sharkie-0000/split-keyboard/bom.csv

Name | Quantity | Price | Total cost | Currency | URL
Seeed Studio XIAO RP2040 v1.0 | 2 | 5.64 | 11.28 | USD | https://robu.in/product/seeed-studio-xiao-rp2040-v1-0/
Blank Pudding Keycap Set | 1 | 15.99 | 15.99 | USD | https://meckeys.com/shop/accessories/keyboard-accessories/keycaps/blank-pudding-keycap-set/
DIODE-1N4148-SOD-80 (SKU 1415737) | 52 | 0.0109 | 0.57 | USD | https://robu.in/product/diode-1n4148/
PCB fabrication (JLCPCB order) | 1 | 23.00 | 23.00 | USD | https://jlcpcb.com/
LHGJFKO 3-pin mechanical keyboard switches (150-piece pack) | 1 | 18.11 | 18.11 | USD | https://www.amazon.in/dp/B0GFDG9GB7
TOTAL |  |  | 68.95 | USD
