sharkie-0000/split-keyboard/3d/s-split-keyboard.step

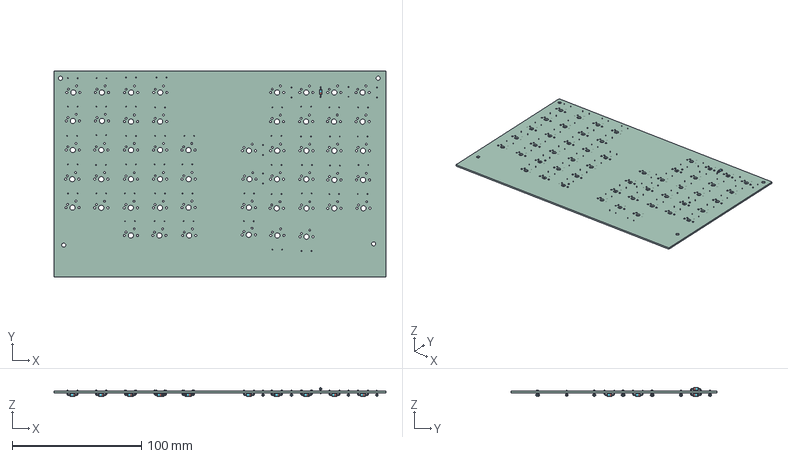
[picture p6: CAD file, 2026-11-12]
3d/s-split-keyboard.step
256.5 x 159.1 x 6.70 mm
D_DO-35_SOD27_P7.62mm_Horizontal x 52
s-split-keyboard-unsaved-export-dYNJtc_PCB
