sharkie-0000/split-keyboard/3d/printable-s-split-keyboard.stl

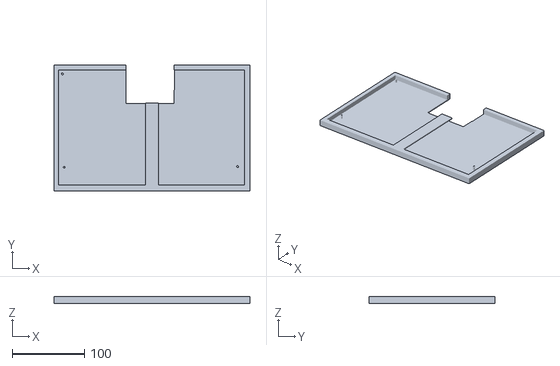
[picture p7: CAD file, 2026-11-12]
3d/printable-s-split-keyboard.stl
270.7 x 173.8 x 9.00
