sharkie-0000/split-keyboard/kicad/s-split-keyboard.kicad_pcb

## KiCad design kicad/s-split-keyboard.kicad_pcb (2026-11-12)

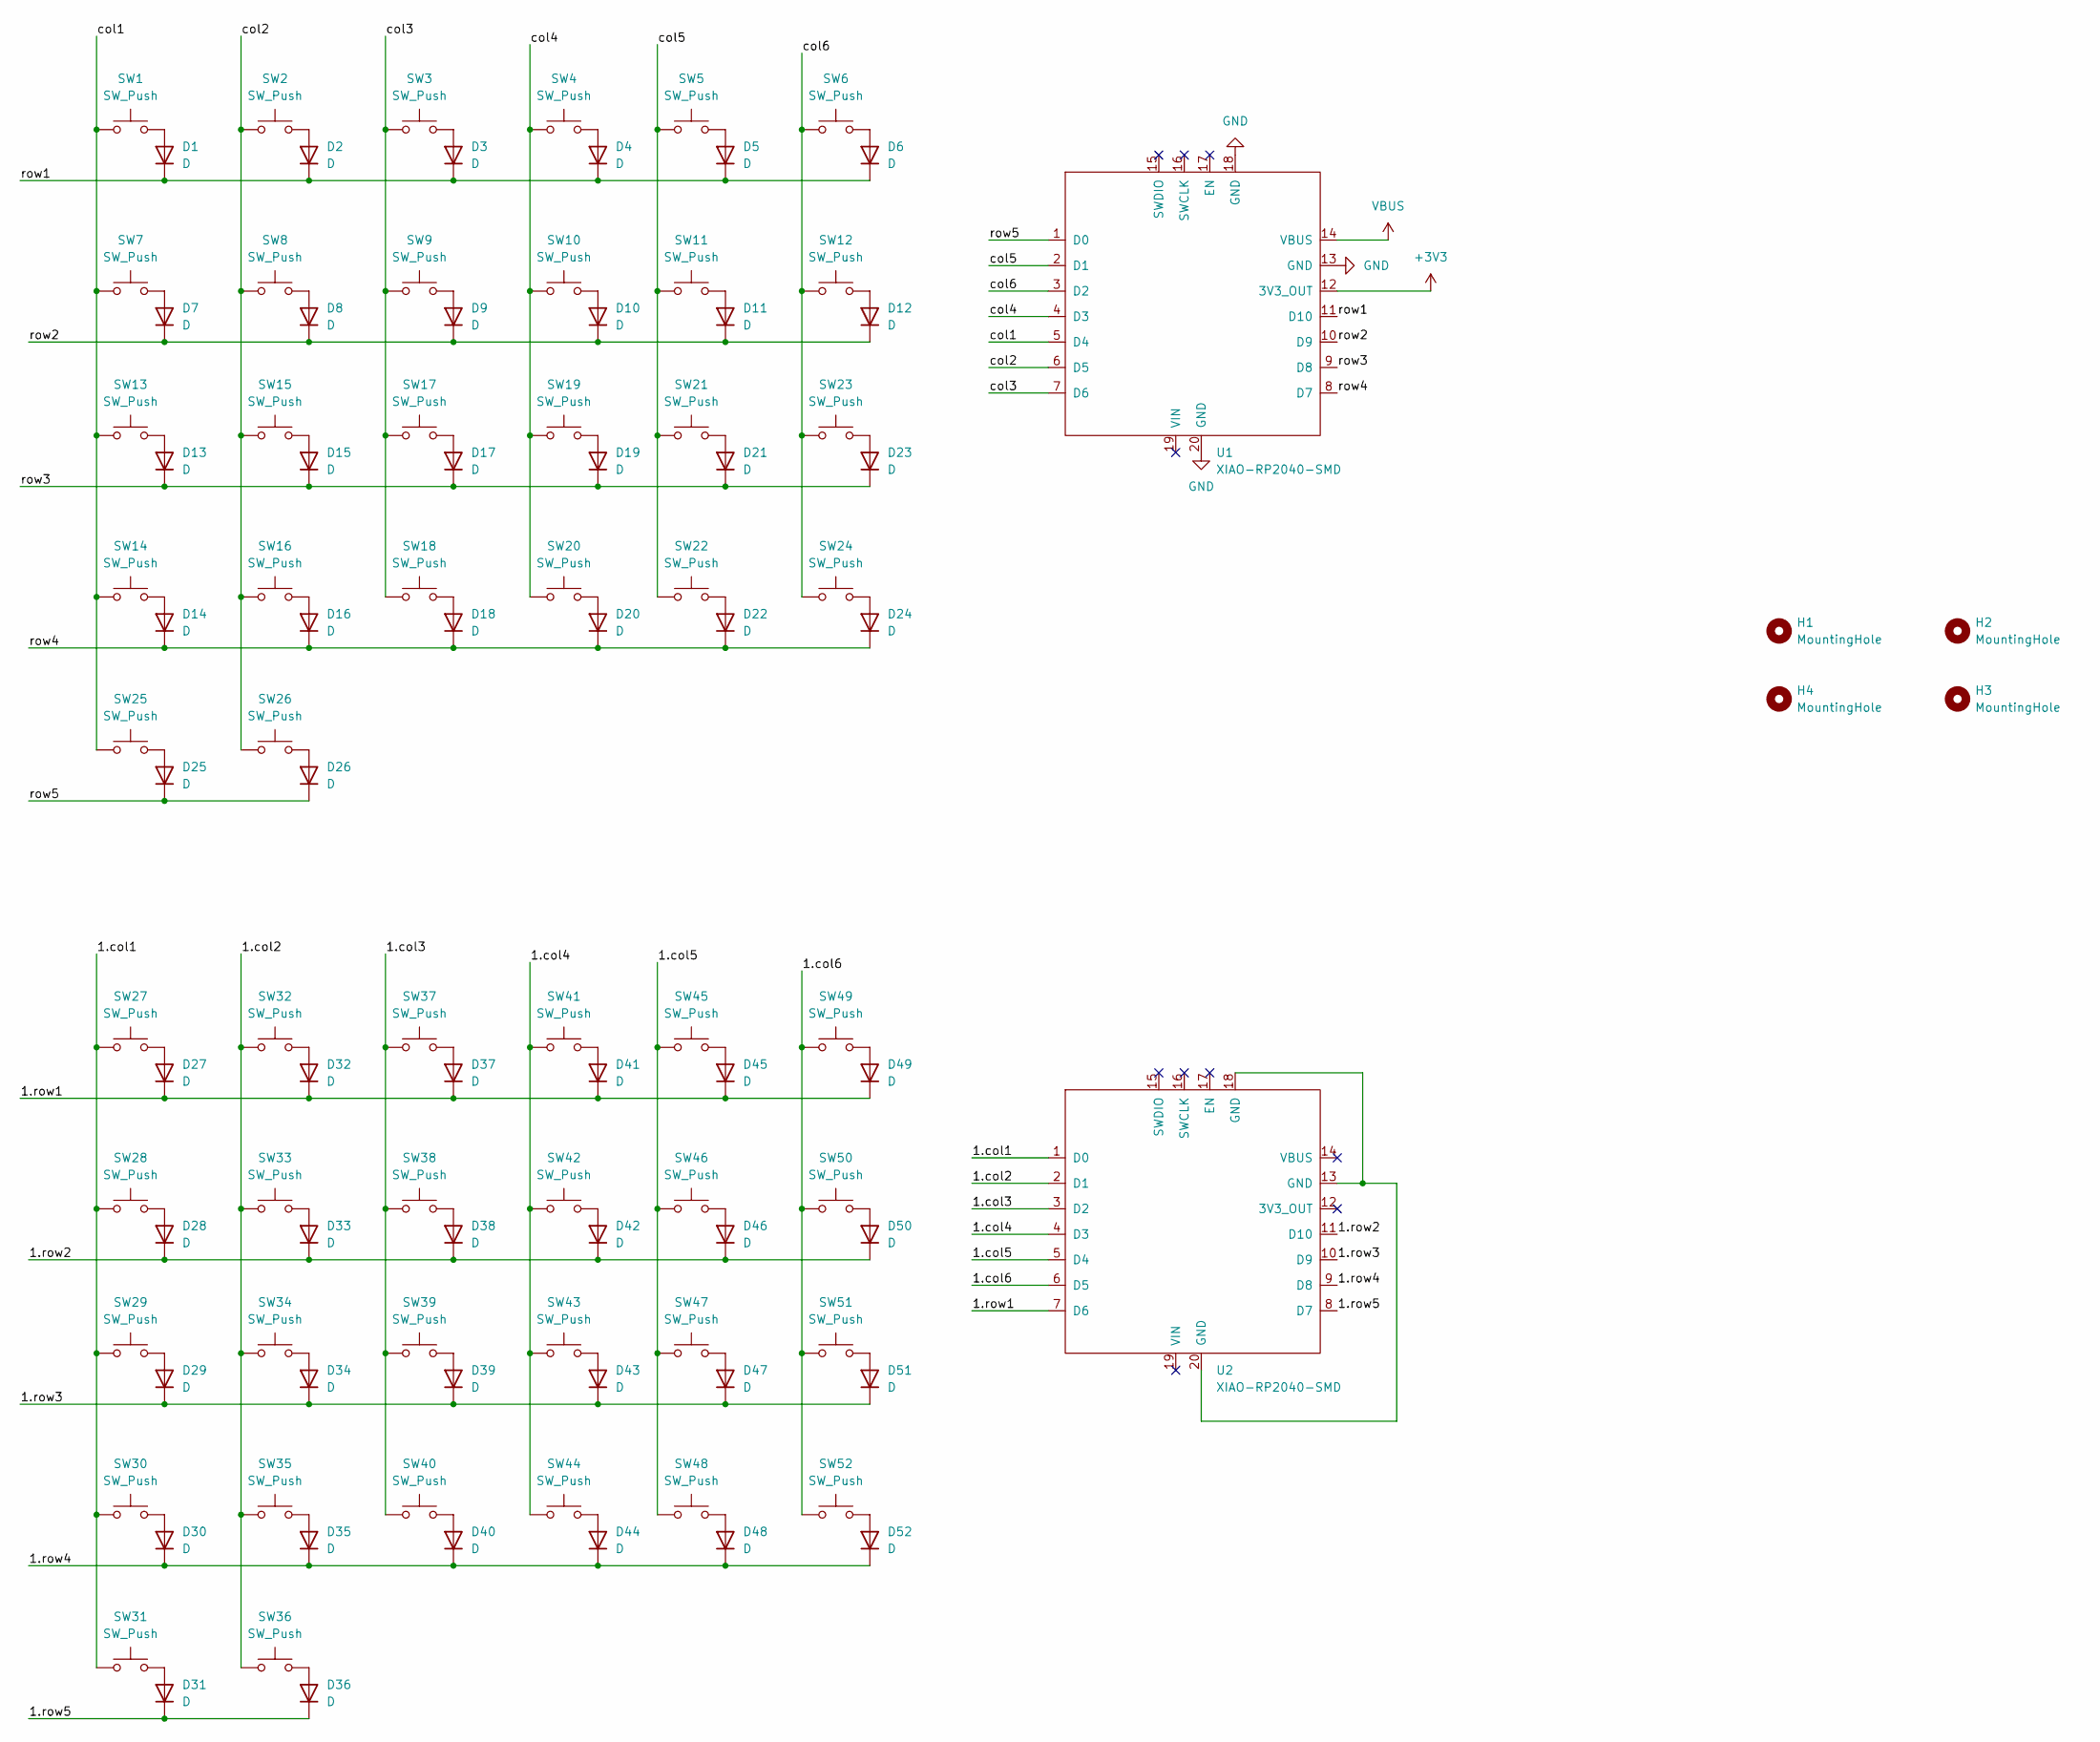
[picture p51: schematic s-split-keyboard.kicad_sch]

Parts:
D1, D2, D3, D4, D5, D6, D7, D8, D9, D10, D11, D12, D13, D14, D15, D16, D17, D18, D19, D20, D21, D22, D23, D24, D25, D26, D27, D28, D29, D30, D31, D32, D33, D34, D35, D36, D37, D38, D39, D40, D41, D42, D43, D44, D45, D46, D47, D48, D49, D50, D51, D52: D; D_DO-35_SOD27_P7.62mm_Horizontal
H1, H2, H3, H4: MountingHole; MountingHole_3.2mm_M3
SW1, SW2, SW3, SW4, SW5, SW6, SW7, SW8, SW9, SW10, SW11, SW12, SW13, SW14, SW15, SW16, SW17, SW18, SW19, SW20, SW21, SW22, SW23, SW24, SW25, SW26, SW27, SW28, SW29, SW30, SW31, SW32, SW33, SW34, SW35, SW36, SW37, SW38, SW39, SW40, SW41, SW42, SW43, SW44, SW45, SW46, SW47, SW48, SW49, SW50, SW51, SW52: SW_Push; SW_Cherry_MX_1.00u_PCB
U1, U2: XIAO-RP2040-SMD

Connections:
+3V3: U1.12 (3V3_OUT)
/1.col1: SW27.1, SW28.1, SW29.1, SW30.1, SW31.1, U2.1 (D0)
/1.col2: SW32.1, SW33.1, SW34.1, SW35.1, SW36.1, U2.2 (D1)
/1.col3: SW37.1, SW38.1, SW39.1, SW40.1, U2.3 (D2)
/1.col4: SW41.1, SW42.1, SW43.1, SW44.1, U2.4 (D3)
/1.col5: SW45.1, SW46.1, SW47.1, SW48.1, U2.5 (D4)
/1.col6: SW49.1, SW50.1, SW51.1, SW52.1, U2.6 (D5)
/1.row1: D27.1 (K), D32.1 (K), D37.1 (K), D41.1 (K), D45.1 (K), D49.1 (K), U2.7 (D6)
/1.row2: D28.1 (K), D33.1 (K), D38.1 (K), D42.1 (K), D46.1 (K), D50.1 (K), U2.11 (D10)
/1.row3: D29.1 (K), D34.1 (K), D39.1 (K), D43.1 (K), D47.1 (K), D51.1 (K), U2.10 (D9)
/1.row4: D30.1 (K), D35.1 (K), D40.1 (K), D44.1 (K), D48.1 (K), D52.1 (K), U2.9 (D8)
/1.row5: D31.1 (K), D36.1 (K), U2.8 (D7)
/col1: SW1.1, SW7.1, SW13.1, SW14.1, SW25.1, U1.5 (D4)
/col2: SW2.1, SW8.1, SW15.1, SW16.1, SW26.1, U1.6 (D5)
/col3: SW3.1, SW9.1, SW17.1, SW18.1, U1.7 (D6)
/col4: SW4.1, SW10.1, SW19.1, SW20.1, U1.4 (D3)
/col5: SW5.1, SW11.1, SW21.1, SW22.1, U1.2 (D1)
/col6: SW6.1, SW12.1, SW23.1, SW24.1, U1.3 (D2)
/row1: D1.1 (K), D2.1 (K), D3.1 (K), D4.1 (K), D5.1 (K), D6.1 (K), U1.11 (D10)
/row2: D7.1 (K), D8.1 (K), D9.1 (K), D10.1 (K), D11.1 (K), D12.1 (K), U1.10 (D9)
/row3: D13.1 (K), D15.1 (K), D17.1 (K), D19.1 (K), D21.1 (K), D23.1 (K), U1.9 (D8)
/row4: D14.1 (K), D16.1 (K), D18.1 (K), D20.1 (K), D22.1 (K), D24.1 (K), U1.8 (D7)
/row5: D25.1 (K), D26.1 (K), U1.1 (D0)
GND: U1.13 (GND), U1.18 (GND), U1.20 (GND)
unnamed: D1.2 (A), SW1.2
unnamed: D2.2 (A), SW2.2
unnamed: D3.2 (A), SW3.2
unnamed: D4.2 (A), SW4.2
unnamed: D5.2 (A), SW5.2
unnamed: D6.2 (A), SW6.2
unnamed: D7.2 (A), SW7.2
unnamed: D8.2 (A), SW8.2
unnamed: D9.2 (A), SW9.2
unnamed: D10.2 (A), SW10.2
unnamed: D11.2 (A), SW11.2
unnamed: D12.2 (A), SW12.2
unnamed: D13.2 (A), SW13.2
unnamed: D14.2 (A), SW14.2
unnamed: D15.2 (A), SW15.2
unnamed: D16.2 (A), SW16.2
unnamed: D17.2 (A), SW17.2
unnamed: D18.2 (A), SW18.2
unnamed: D19.2 (A), SW19.2
unnamed: D20.2 (A), SW20.2
unnamed: D21.2 (A), SW21.2
unnamed: D22.2 (A), SW22.2
unnamed: D23.2 (A), SW23.2
unnamed: D24.2 (A), SW24.2
unnamed: D25.2 (A), SW25.2
unnamed: D26.2 (A), SW26.2
unnamed: D27.2 (A), SW27.2
unnamed: D28.2 (A), SW28.2
unnamed: D29.2 (A), SW29.2
unnamed: D30.2 (A), SW30.2
unnamed: D31.2 (A), SW31.2
unnamed: D32.2 (A), SW32.2
unnamed: D33.2 (A), SW33.2
unnamed: D34.2 (A), SW34.2
unnamed: D35.2 (A), SW35.2
unnamed: D36.2 (A), SW36.2
unnamed: D37.2 (A), SW37.2
unnamed: D38.2 (A), SW38.2
unnamed: D39.2 (A), SW39.2
unnamed: D40.2 (A), SW40.2
unnamed: D41.2 (A), SW41.2
unnamed: D42.2 (A), SW42.2
unnamed: D43.2 (A), SW43.2
unnamed: D44.2 (A), SW44.2
unnamed: D45.2 (A), SW45.2
unnamed: D46.2 (A), SW46.2
unnamed: D47.2 (A), SW47.2
unnamed: D48.2 (A), SW48.2
unnamed: D49.2 (A), SW49.2
unnamed: D50.2 (A), SW50.2
unnamed: D51.2 (A), SW51.2
unnamed: D52.2 (A), SW52.2
unnamed: U2.13 (GND), U2.18 (GND), U2.20 (GND)
VBUS: U1.14 (VBUS)

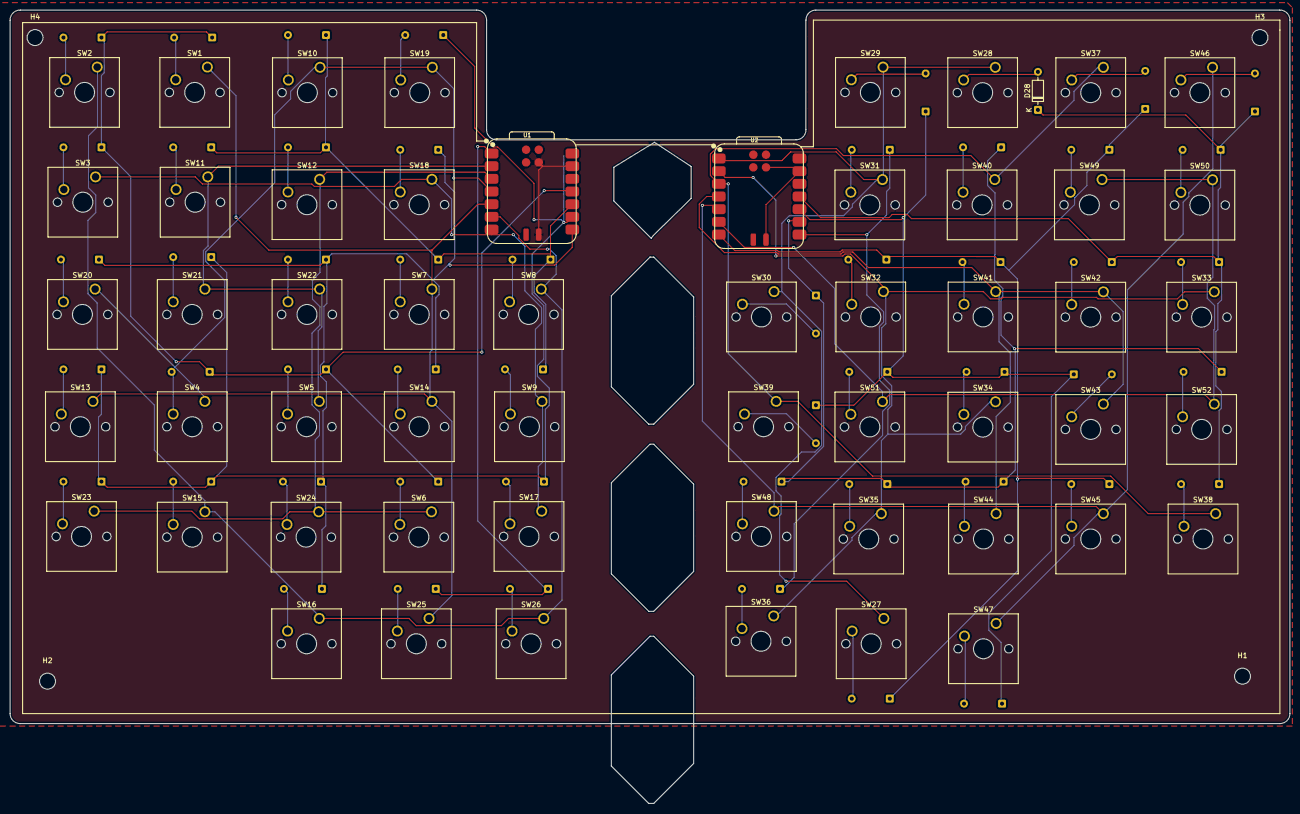
[picture p52: board s-split-keyboard.kicad_pcb from above]

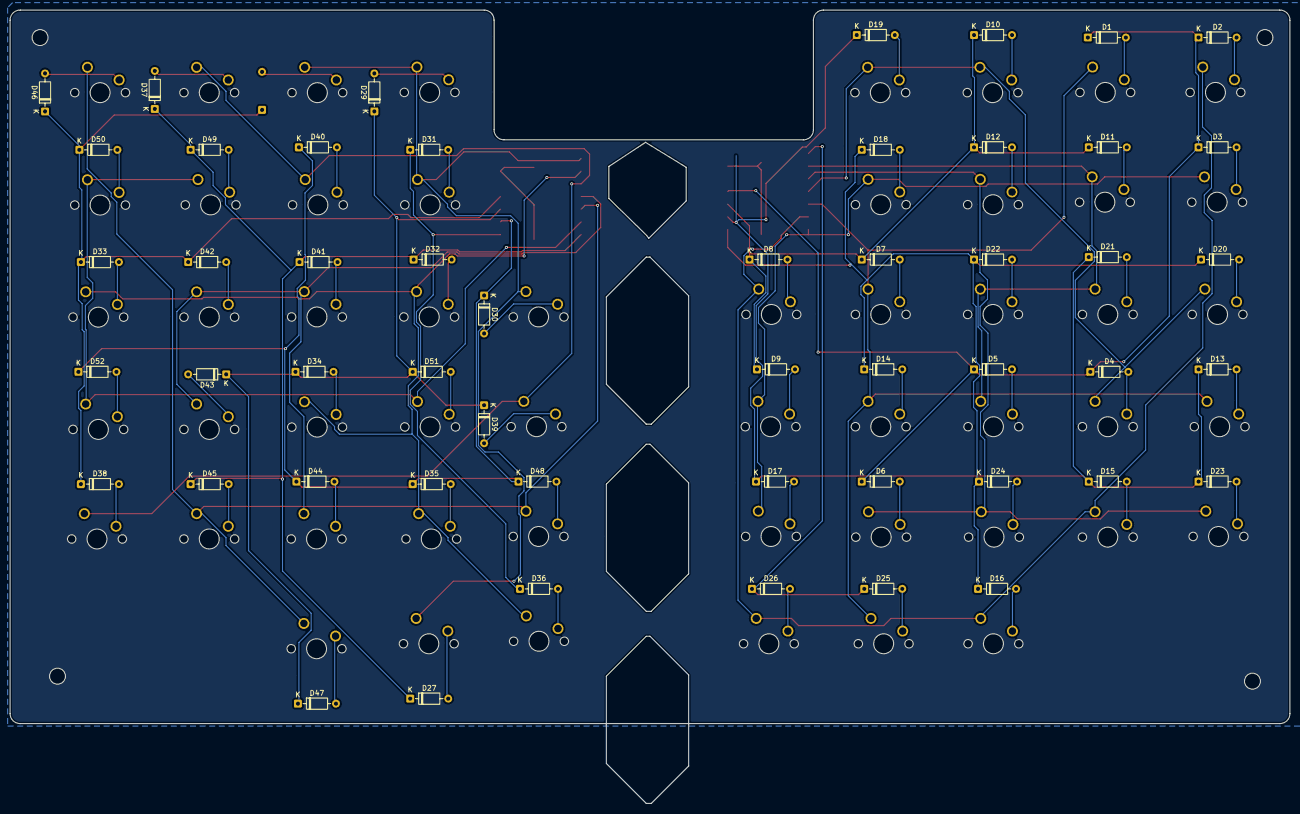
[picture p53: board s-split-keyboard.kicad_pcb from below]

Board: 2 copper layers, 256.5 x 143.0 mm, 110 parts (51 on the bottom side), 76 nets.
